balewski/plant_lineFolower/cad_parts/assembly_sep24/main_photo_sensor.FCStd

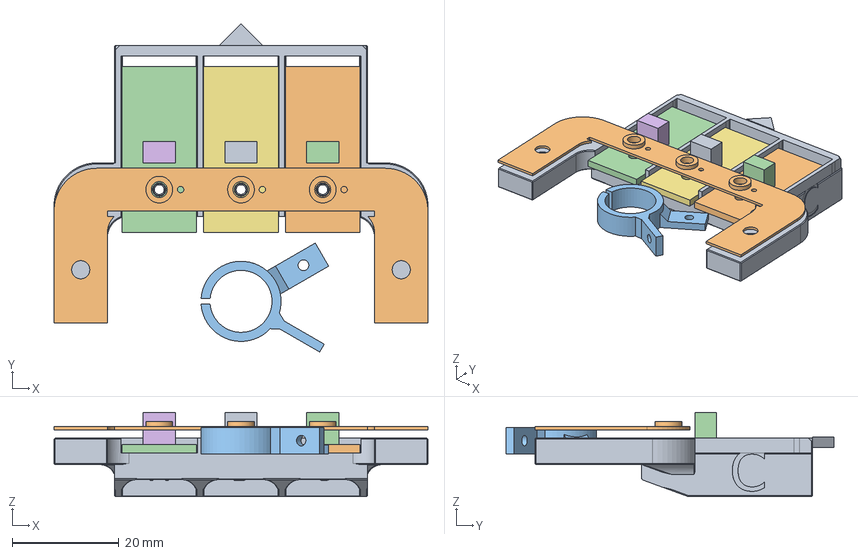
[picture p1: CAD file, 2026-10-09]
cad_parts/assembly_sep24/main_photo_sensor.FCStd
70.0 x 61.4 x 15.8 mm
Sensor holder — raised arms and rounded outer shoulders
U cover — 0.3 mm over both arms and the bar
Buzzer holder — 5 mm clear of the arms, top flush with the U cover
Module 1 PCB — 31 × 14; hole 23 mm from sensor end; thickness illustrative
Downward-facing sensor 1 — between optical separators; illustrative envelope
Module 1 electronics-side marker — schematic, not actual component footprint
Module 2 PCB — 31 × 14; hole 23 mm from sensor end; thickness illustrative
Downward-facing sensor 2 — between optical separators; illustrative envelope
Module 2 electronics-side marker — schematic, not actual component footprint
Module 3 PCB — 31 × 14; hole 23 mm from sensor end; thickness illustrative
Downward-facing sensor 3 — between optical separators; illustrative envelope
Module 3 electronics-side marker — schematic, not actual component footprint
