balewski/plant_lineFolower/cad_parts/assembly_sep24/main_upper_deck.FCStd

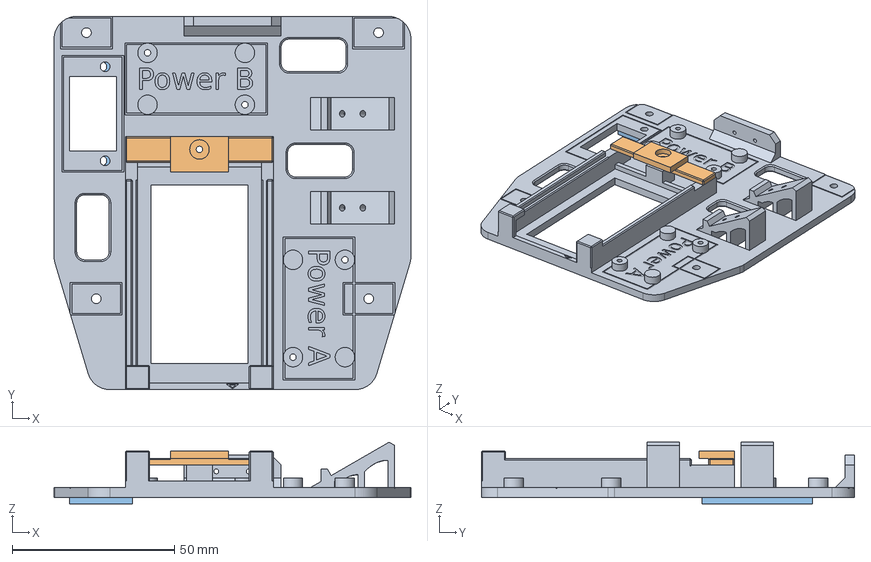
[picture p2: CAD file, 2026-10-04]
cad_parts/assembly_sep24/main_upper_deck.FCStd
110.0 x 115.0 x 19.0 mm
Upper deck — electronics mounts and front tab
Removable Teensy clasp — 2 mm thick — flat — one locking tab
Removable A-meter C riser
