balewski/plant_lineFolower/cad_parts/assembly_sep24/main_overview.FCStd

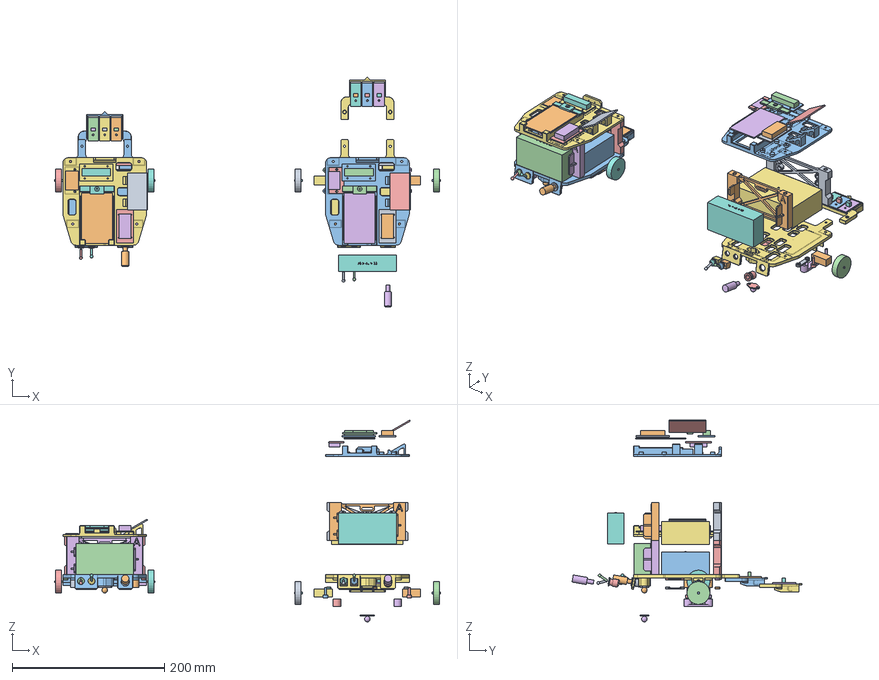
[picture p3: CAD file, 2026-10-04]
cad_parts/assembly_sep24/main_overview.FCStd
507.0 x 302.1 x 265.1 mm
LeftMotorClamp
RightMotorClamp
ChassisWithLeftMotorA
CableClamp1
CableClamp2
CableClamp3
LeftMotorScrewReference0
LeftMotorScrewReference1
RightMotorScrewReference0
RightMotorScrewReference1
LeftMotorEnvelope
LeftDShaft
LeftWheelEnvelope
RightMotorEnvelope
RightDShaft
RightWheelEnvelope
CasterFlangeReference
CasterBallReference
PhotoSensorHolder
PCBReference1
SensorFaceReference1
TrimmerReference1
PCBReference2
SensorFaceReference2
TrimmerReference2
PCBReference3
SensorFaceReference3
TrimmerReference3
FrontPillarFrame
AftPillarFrame
TeensyPlatform
BoardRetainingClamp
AmmeterSupportC
TeensyPCB
PiEnclosure
BatteryPack
PowerAPCB
PowerAComponents
PowerBPCB
PowerBComponents
MotorDriverPCB
AmmeterDisplay
Toggle1Body
Toggle1Mount
Toggle1Lever
Toggle2Body
Toggle2Mount
Toggle2Lever
PowerSocket
PowerPlug
PiEnclosureLabel
BatteryPackLabel
LeftMotorClamp001
RightMotorClamp001
ChassisWithLeftMotorA001
CableClamp001
CableClamp002
CableClamp003
LeftMotorScrewReference001
LeftMotorScrewReference002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
