balewski/plant_lineFolower/cad_parts/assembly_sep24/main_lower_deck.FCStd

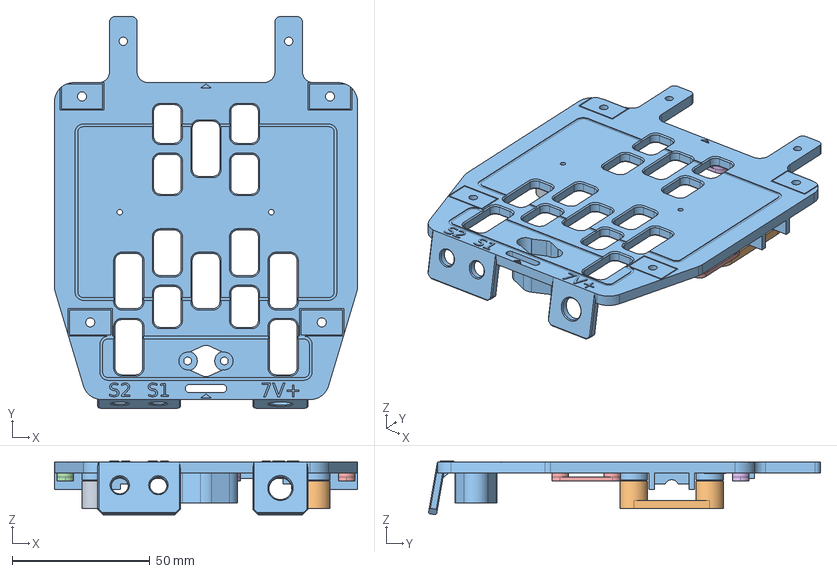
[picture p4: CAD file, 2026-10-04]
cad_parts/assembly_sep24/main_lower_deck.FCStd
110.0 x 142.2 x 19.4 mm
Left motor strap — recessed screw heads below, inserts in platform
Right motor strap — recessed screw heads below, inserts in platform
110 × 115 mm chassis — Pi and battery outlines, switch and socket panels001 — A and B under the deck, beside the forward motor screws
Cable clamp 1 — underside, along frame edge
Cable clamp 2 — underside, along frame edge
Cable clamp 3 — underside, along frame edge
