balewski/plant_lineFolower/cad_parts/assembly_sep24/main_pillars.FCStd

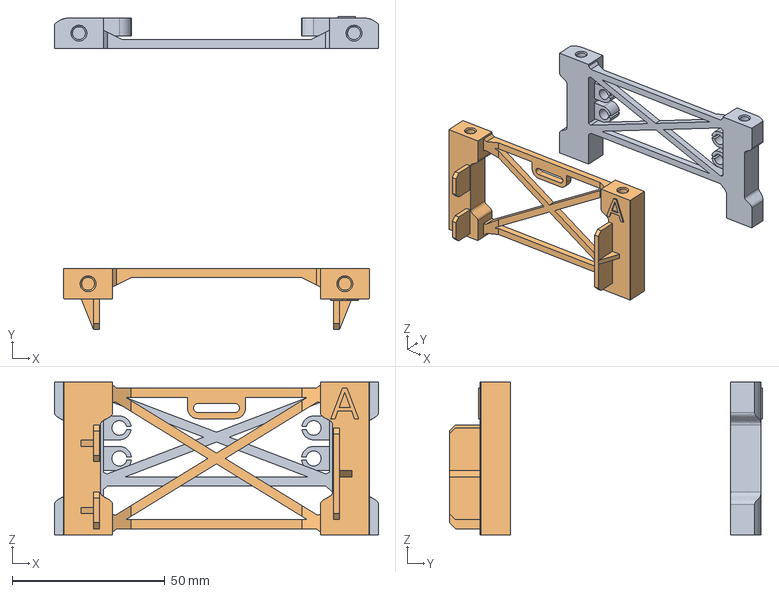
[picture p5: CAD file, 2026-10-04]
cad_parts/assembly_sep24/main_pillars.FCStd
106.0 x 102.5 x 50.0 mm
Front pillars — F
Aft pillars — A
