balewski/plant_lineFolower/cad_parts/assembly_sep24/main_roof.FCStd

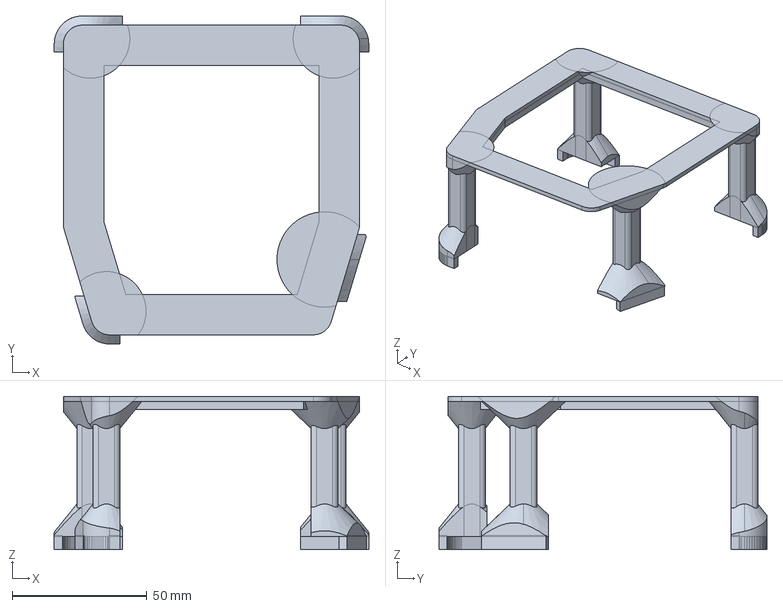
[picture p6: CAD file, 2026-10-04]
cad_parts/assembly_sep24/main_roof.FCStd
116.8 x 121.8 x 57.0 mm
