balewski/plant_lineFolower/cad_parts/assembly_sep24/README.md

# September 24 robot assembly

The native FreeCAD files are the design sources; there are no builder scripts for them in this tree. Edit them in FreeCAD, then re-export the affected print plate (see [AGENTS.md](AGENTS.md)).

## Contents

| Path | Purpose |
| :--- | :--- |
| `main_lower_deck.FCStd` | Chassis with motor mounts, two motor clamps, three cable clamps, installed photo-sensor holder and hardware references |
| `main_pillars.FCStd` | Front and aft pillar frames standing on the deck |
| `main_upper_deck.FCStd` | Upper platform (Teensy/electronics), board retaining clamp, ammeter support |
| `main_roof.FCStd` | Conical roof |
| `main_photo_sensor.FCStd` | Standalone sensor holder, cover strip and buzzer holder |
| `main_overview.FCStd` | Assembled and exploded visualization, regenerated by `overview/build_overview.py`; see [overview/README.md](overview/README.md) |
| `print_*/` | Per-plate `export_print.py`, QIDIStudio `machine.json`, `process.json`, `filament.json` |
| `assets/` | `DejaVuSans.ttf`, used by `overview/build_overview.py` for its text labels |
| `tmp/` | Git-ignored working area for regenerable output (STLs, 3MFs, slices, previews, reports); safe to overwrite or delete |

## Printed parts

| Part | Source file | Print dir | Envelope X × Y × Z (mm) |
| :--- | :--- | :--- | :--- |
| ChassisWithLeftMotorA | `main_lower_deck` | `print_lower_deck` | 110 × 142.2 × 19.4 |
| LeftMotorClamp | `main_lower_deck` | `print_lower_deck` | 10 × 37.5 × 9.9 |
| CableClamp1–3 | `main_lower_deck` | `print_lower_deck` | 6 × 25 × 3 (CableClamp3 is 25 × 6 × 3) |
| FrontPillarFrame | `main_pillars` | `print_pillars_sensor` | 106 × 10.5 × 50 |
| AftPillarFrame | `main_pillars` | `print_pillars_sensor` | 100 × 20 × 50 |
| SensorHolder, CoverStrip, BuzzerHolder | `main_photo_sensor` | `print_pillars_sensor` (holder), `print_photo_sensor` | 70 × 56 × 11.2; 70 × 29 × 1.6; 23.9 × 20.4 × 5 |
| TeensyPlatform | `main_upper_deck` | `print_upper_deck` | 110 × 115 × 17 |
| BoardRetainingClamp | `main_upper_deck` | `print_upper_deck` | 45.6 × 11 × 4.4 |
| AmmeterSupportC | `main_upper_deck` | `print_upper_deck` | 19.5 × 34 × 2 |
| MainRoof | `main_roof` | `print_roof_conical` | 119.2 × 130.4 × 57 |

`main_lower_deck.FCStd` also holds `RightMotorClamp`, a mirror of the left clamp that is not on a print plate. Cable clamp centers are (-51,-29), (51,-29) and (0,27) mm.

The deck underside is Z=0 in the lower-deck file. Pillar frames span Z=4 to 54 and the upper platform starts at Z=54.

## Rebuilding and checking

Run FreeCAD scripts with the bundled interpreter:

```sh
PYTHONPATH=/Applications/FreeCAD.app/Contents/Resources/lib \
/Applications/FreeCAD.app/Contents/Resources/bin/python <script>.py
```

- `print_*/export_print.py` exports closed STL meshes and a packed 3MF to `tmp/`, and fails if a mesh is not a closed manifold solid or its volume differs from the CAD solid by more than 0.1%.
- `overview/build_overview.py` rebuilds `main_overview.FCStd` from the current source files after design changes.
- Geometry checks do not establish physical stiffness or fit. Nothing is printed without the confirmation steps in [AGENTS.md](AGENTS.md).
